VoronDesign/voron-downdraft/STLs/Dual_4010/README.md

# Downdraft Toolhead

These parts are specific to the dual 4010 part cooling toolhead.

The Left and Right Fan mounts house the part cooling fans.

The various Front mounts place the hotend cooling fan at different heights. The height is determined by the location of the heatsink on the hotend. See the [HARDWARE_COMPATIBILITY_LIST](../../HARDWARE_COMPATIBILITY_LIST.md) file for a list of common hotends and which Front mount to use.
