VoronDesign/voron-downdraft/STLs/Extras/Front_Mount_Cutter_Models/README.md

# Downdraft Toolhead

These Front mounts have decorative patterns cut into them. You can either print the 3mf files in 2 colours, or you can hide the cutter parts and print the main Front part to have single colour indented print.
