VoronDesign/voron-downdraft/STLs/Extras/LED_Jigs/README.md

# Downdraft Toolhead

These parts (jigs) are provided to help with soldering wires to the Logo and Nozzle LED's keeping the wires to an appropriate length.
