VoronDesign/voron-downdraft/STLs/Common_Parts/Hotend_Mounts/README.md

# Downdraft Toolhead

Various hotend mounts are provided for mounting to the toolhead. The length of the toolhead and the location of the heatsink is used to determine which height of the toolhead Front mount to use for the hotend fan.
