VoronDesign/voron-downdraft/STLs/Common_Parts/LED_Mounts/README.md

# Downdraft Toolhead

### Logo_LED

Contains parts for an LED behind the logo on the Front part of the toolhead

### Nozzle_LED

Contains parts for logo LED's that direct their light towards the hotend nozzle
