VoronDesign/voron-downdraft/STLs/Common_Parts/Bowden_Mount_Collet.stl

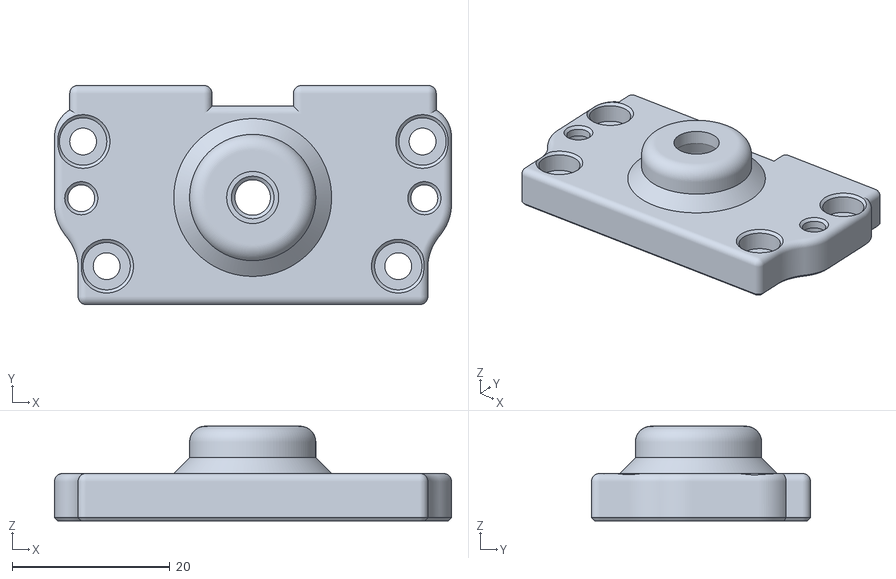
[picture p2: CAD file, 2026-10-25]
STLs/Common_Parts/Bowden_Mount_Collet.stl
50.3 x 27.8 x 12.0
