VoronDesign/voron-downdraft/STLs/Common_Parts/Hotend_Mounts/RapidoHF_DragonVolcano_Mount.stl

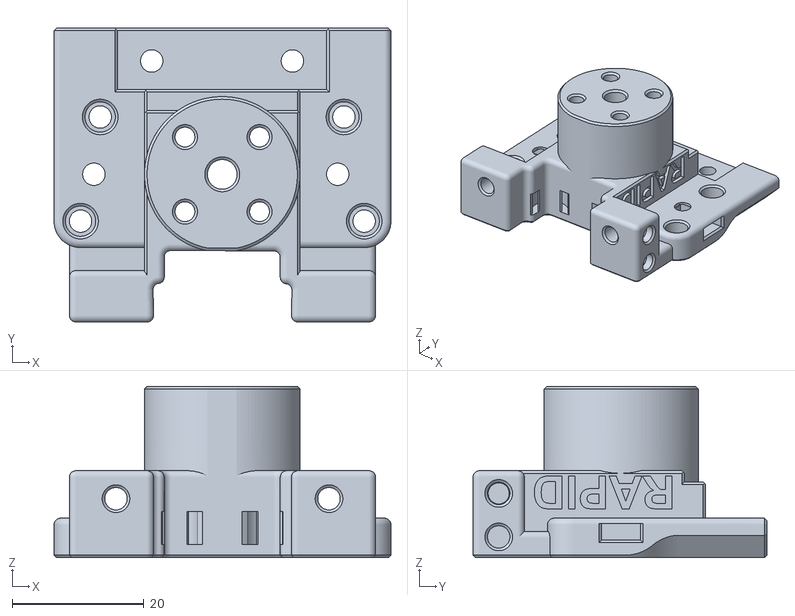
[picture p3: CAD file, 2026-10-25]
STLs/Common_Parts/Hotend_Mounts/RapidoHF_DragonVolcano_Mount.stl
51.1 x 44.6 x 26.0
