VoronDesign/voron-downdraft/STLs/Common_Parts/LED_Mounts/Logo_LED/[c]_LED_Diffuser.stl

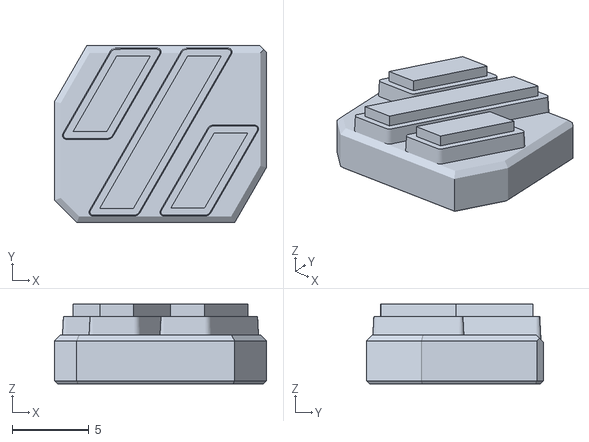
[picture p4: CAD file, 2026-10-25]
STLs/Common_Parts/LED_Mounts/Logo_LED/[c]_LED_Diffuser.stl
13.8 x 11.5 x 5.20
