VoronDesign/voron-downdraft/STLs/Common_Parts/LED_Mounts/Nozzle_LED/Nozzle_LEDx1_Mount.stl

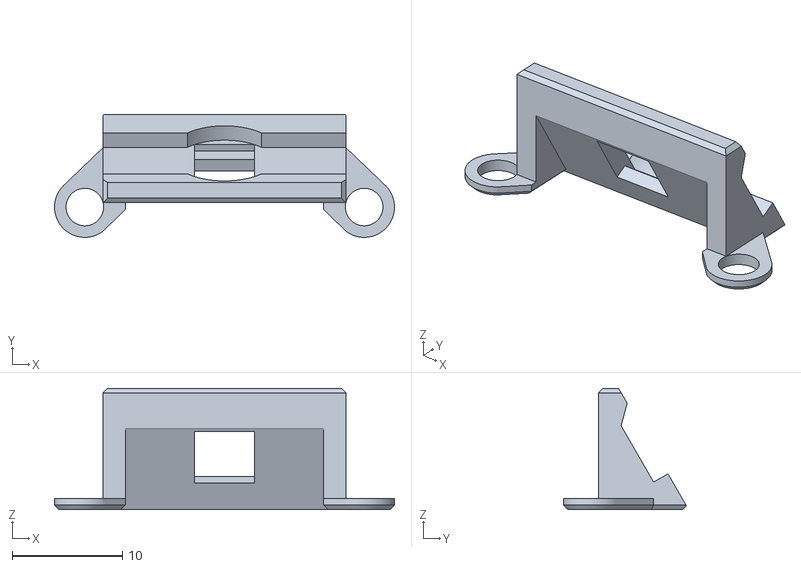
[picture p5: CAD file, 2026-10-25]
STLs/Common_Parts/LED_Mounts/Nozzle_LED/Nozzle_LEDx1_Mount.stl
30.8 x 11.1 x 11.0
