VoronDesign/voron-downdraft/STLs/Common_Parts/PCB_And_Chain_Mounts/Umbilical_PCB_Mounts/PUG_Generic/Umbilical_PCB36_Pug_Mount_Right.stl

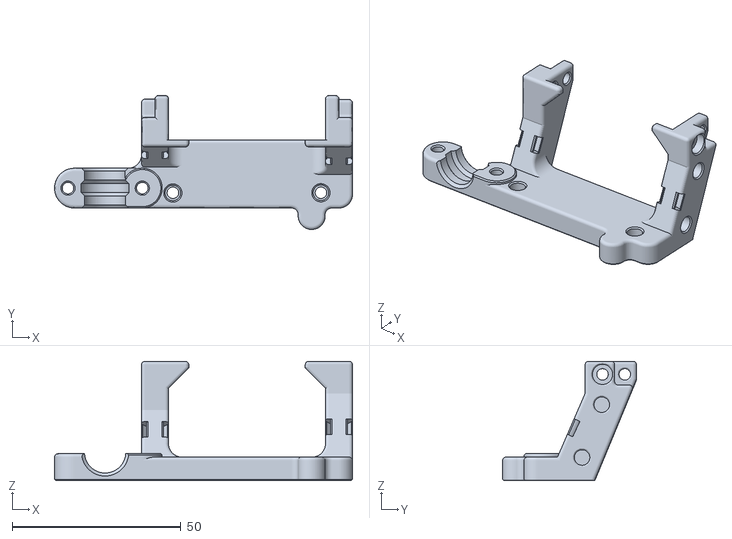
[picture p8: CAD file, 2026-11-10]
STLs/Common_Parts/PCB_And_Chain_Mounts/Umbilical_PCB_Mounts/PUG_Generic/Umbilical_PCB36_Pug_Mount_Right.stl
88.3 x 39.7 x 35.4
