VoronDesign/voron-downdraft/STLs/Common_Parts/PCB_And_Chain_Mounts/Umbilical_PCB_Mounts/WWG2_Umbilical_PCB36_Mount.stl

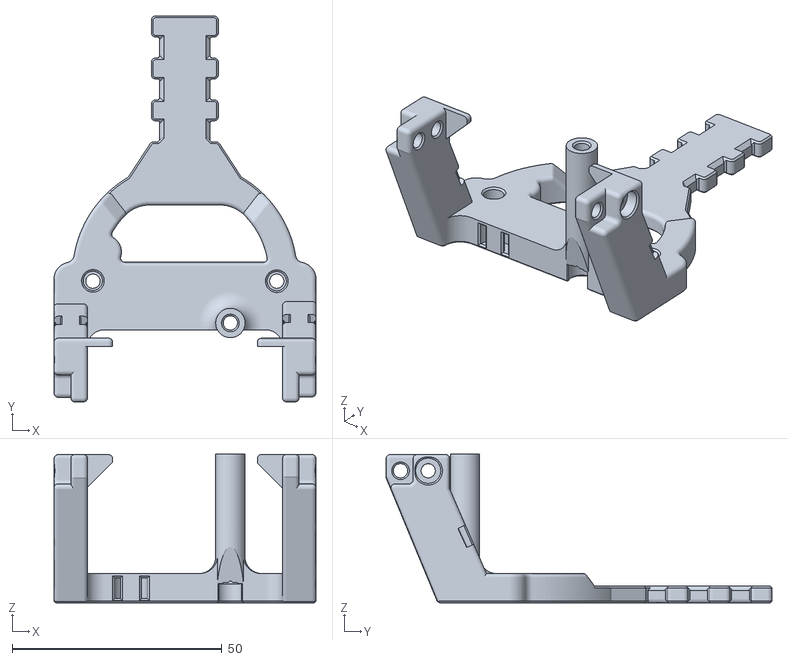
[picture p10: CAD file, 2026-11-10]
STLs/Common_Parts/PCB_And_Chain_Mounts/Umbilical_PCB_Mounts/WWG2_Umbilical_PCB36_Mount.stl
62.5 x 92.0 x 35.5
