VoronDesign/voron-downdraft/STLs/Dual_4010/[a]_4010_Front_Mount_Middle.stl

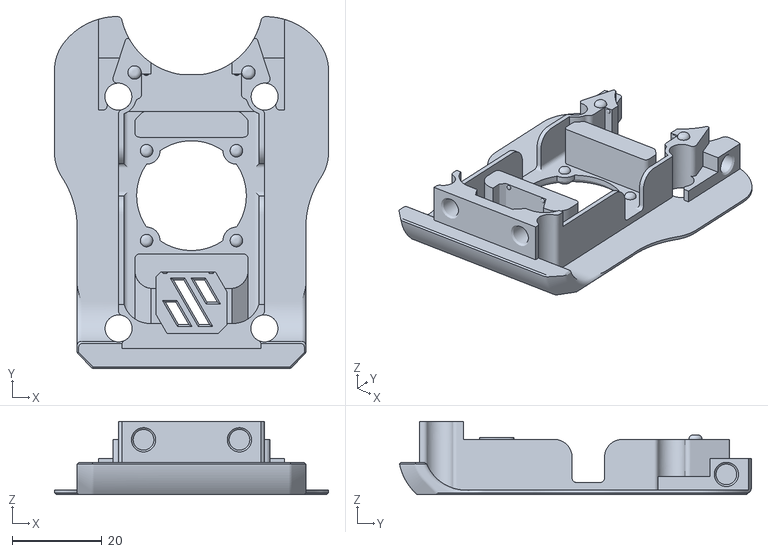
[picture p11: CAD file, 2026-10-25]
STLs/Dual_4010/[a]_4010_Front_Mount_Middle.stl
61.0 x 78.4 x 16.3
