VoronDesign/voron-downdraft/STLs/Dual_5015/5015_Fan_Mount_Left.stl

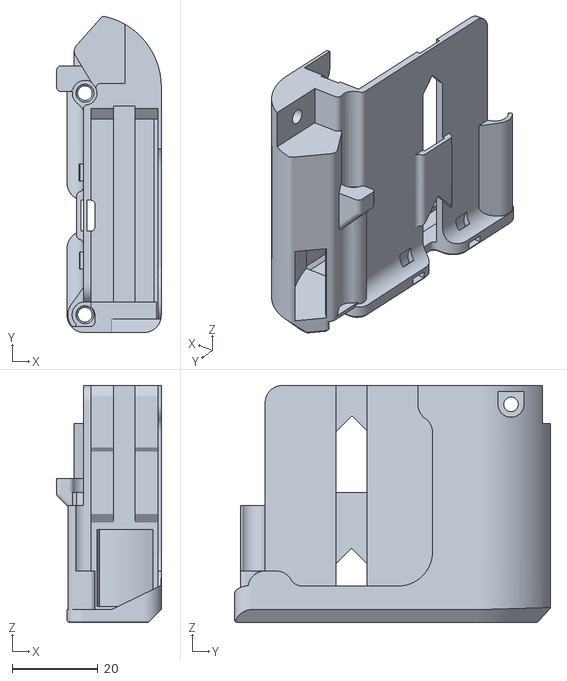
[picture p12: CAD file, 2026-10-25]
STLs/Dual_5015/5015_Fan_Mount_Left.stl
24.4 x 73.6 x 55.2
