VoronDesign/voron-downdraft/STLs/Extras/Crossbow_Cutter_Mount.stl

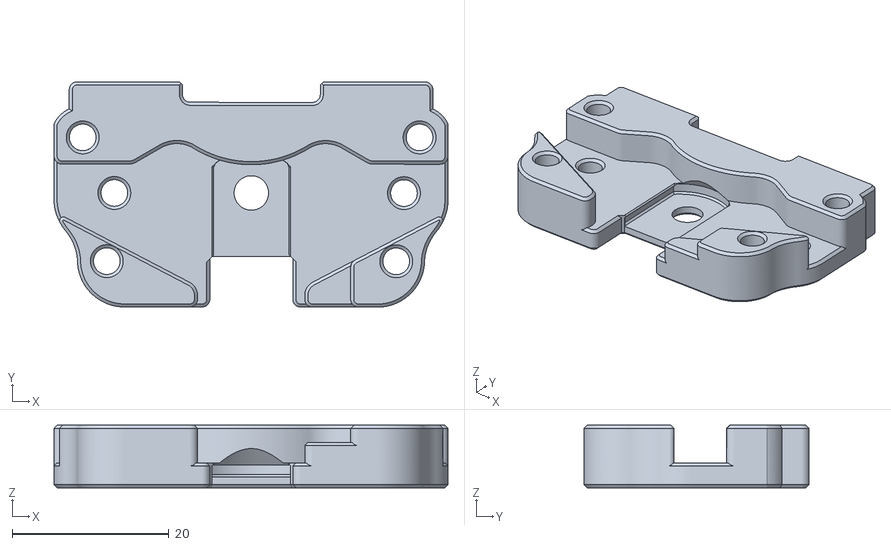
[picture p13: CAD file, 2026-10-25]
STLs/Extras/Crossbow_Cutter_Mount.stl
50.3 x 28.8 x 8.00
