VoronDesign/voron-downdraft/STLs/Extras/LED_Jigs/LEDx2_Logo_Jig.stl

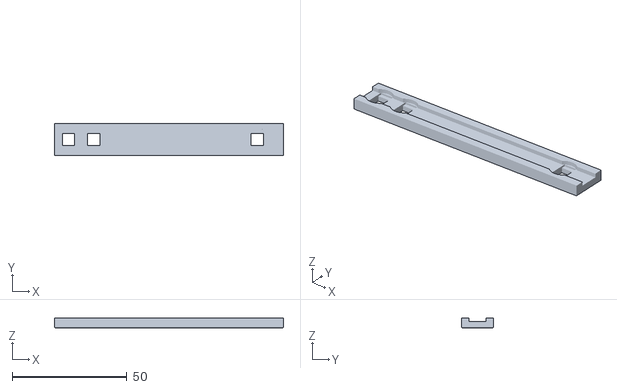
[picture p15: CAD file, 2026-10-25]
STLs/Extras/LED_Jigs/LEDx2_Logo_Jig.stl
100.0 x 14.0 x 4.50
