VoronDesign/voron-downdraft/STLs/Extras/Roto_Vitamins/Roto_Vitamin_Front_Plate_4010.stl

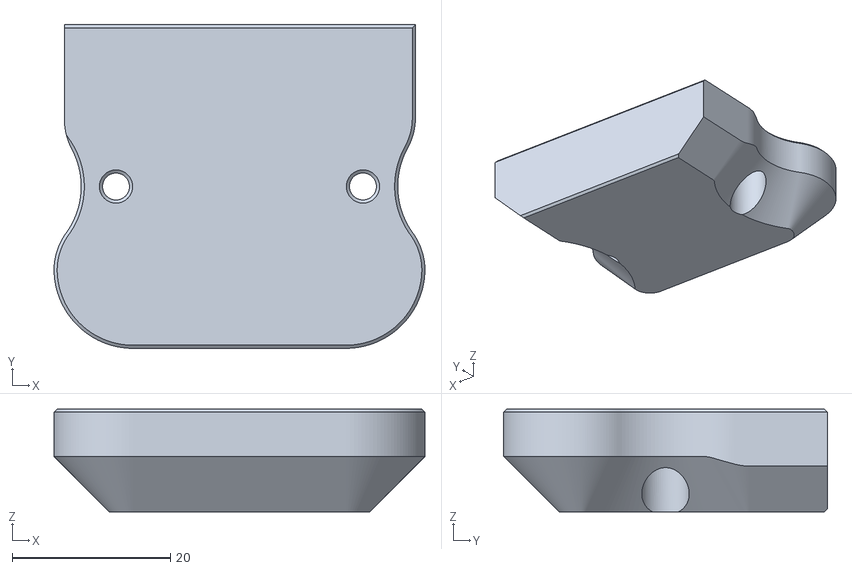
[picture p16: CAD file, 2026-10-25]
STLs/Extras/Roto_Vitamins/Roto_Vitamin_Front_Plate_4010.stl
46.9 x 40.9 x 13.0
