VoronDesign/voron-downdraft/STLs/Common_Parts/Alternative_Extruder_Spacer.stl

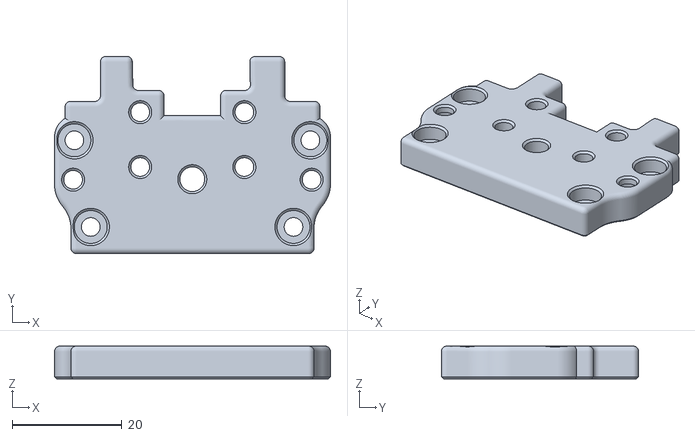
[picture p18: CAD file, 2026-10-25]
STLs/Common_Parts/Alternative_Extruder_Spacer.stl
50.3 x 36.0 x 6.00
