VoronDesign/voron-downdraft/STLs/Common_Parts/Hotend_Mounts/Chube_Compact_Mount.stl

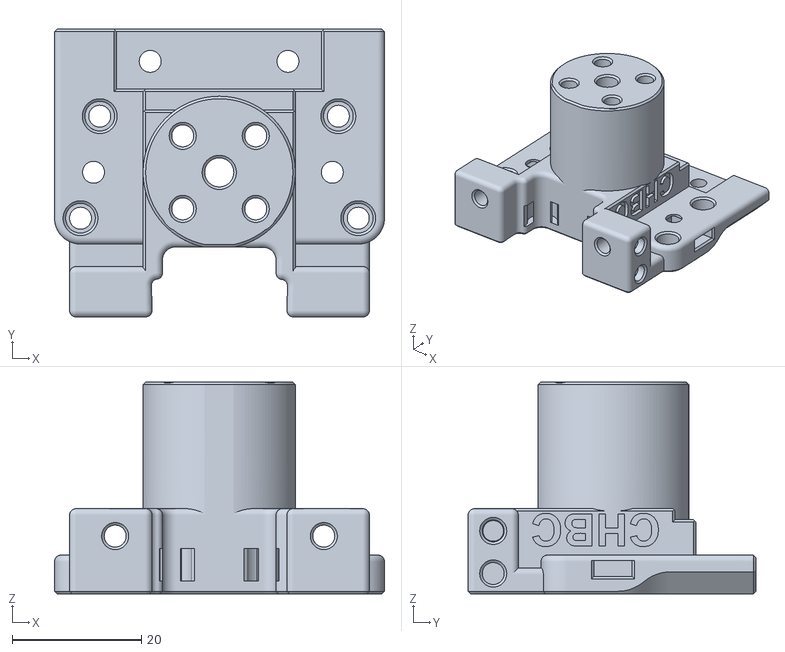
[picture p19: CAD file, 2026-10-25]
STLs/Common_Parts/Hotend_Mounts/Chube_Compact_Mount.stl
51.1 x 44.6 x 32.8
