VoronDesign/voron-downdraft/STLs/Common_Parts/LED_Mounts/Logo_LED/[o]_BARF_LED_Carrier.stl

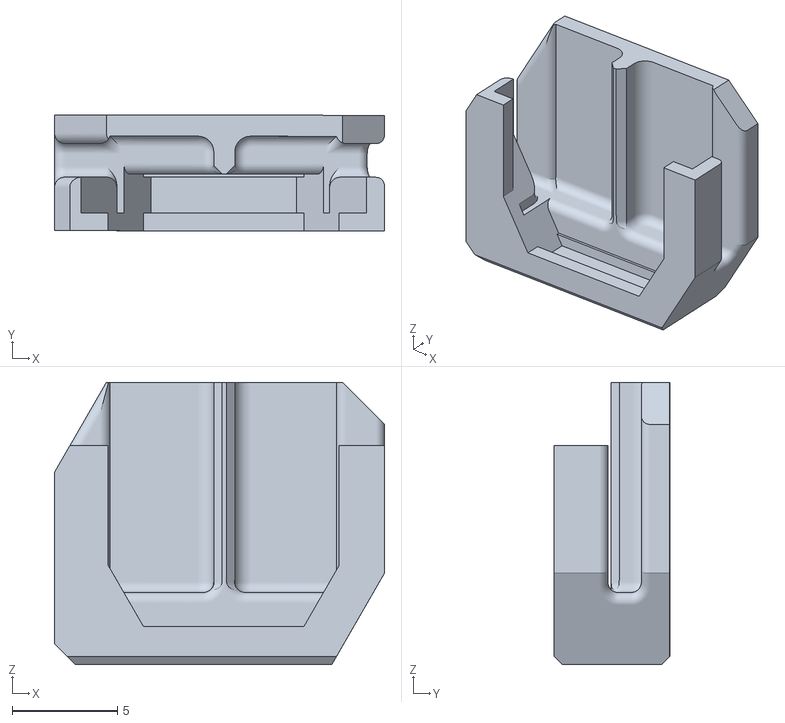
[picture p20: CAD file, 2026-10-25]
STLs/Common_Parts/LED_Mounts/Logo_LED/[o]_BARF_LED_Carrier.stl
15.7 x 5.51 x 13.4
