VoronDesign/voron-downdraft/STLs/Common_Parts/PCB_And_Chain_Mounts/PCB_4mm_Spacer_x2.stl

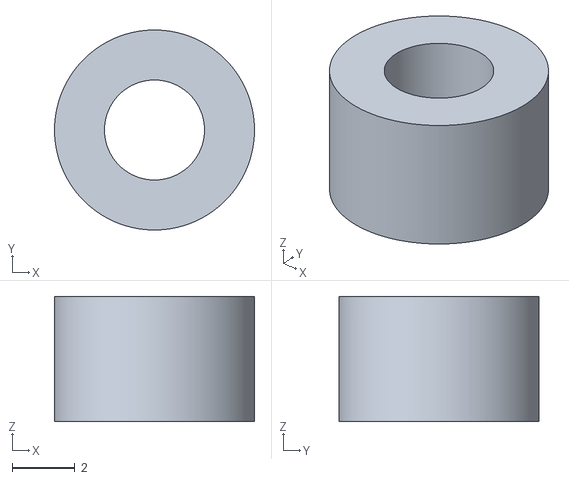
[picture p23: CAD file, 2026-10-25]
STLs/Common_Parts/PCB_And_Chain_Mounts/PCB_4mm_Spacer_x2.stl
6.40 x 6.40 x 4.00
