VoronDesign/voron-downdraft/STLs/Dual_4010/4010_Fan_Mount_Right.stl

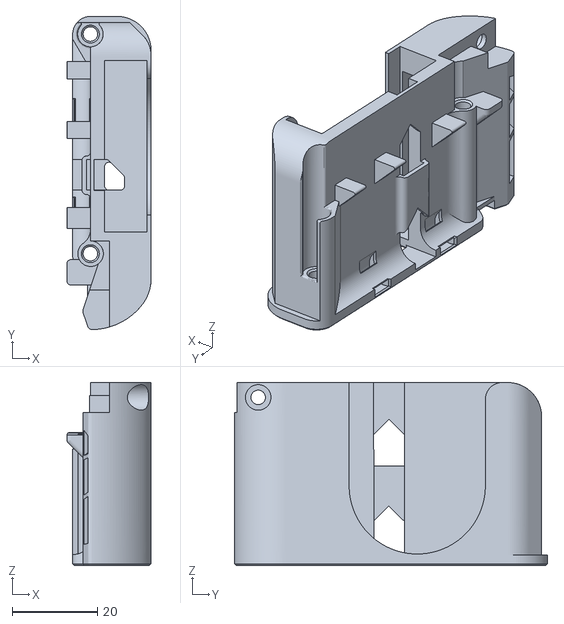
[picture p26: CAD file, 2026-10-25]
STLs/Dual_4010/4010_Fan_Mount_Right.stl
19.8 x 73.6 x 43.0
