VoronDesign/voron-downdraft/STLs/Dual_5015/5015_Fan_Mount_Right.stl

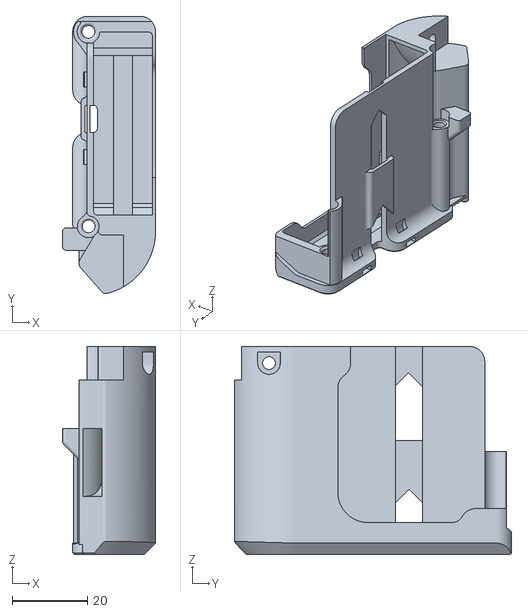
[picture p27: CAD file, 2026-10-25]
STLs/Dual_5015/5015_Fan_Mount_Right.stl
24.6 x 73.6 x 55.2
