VoronDesign/voron-downdraft/STLs/Extras/Generic_ADXL_Mount.stl

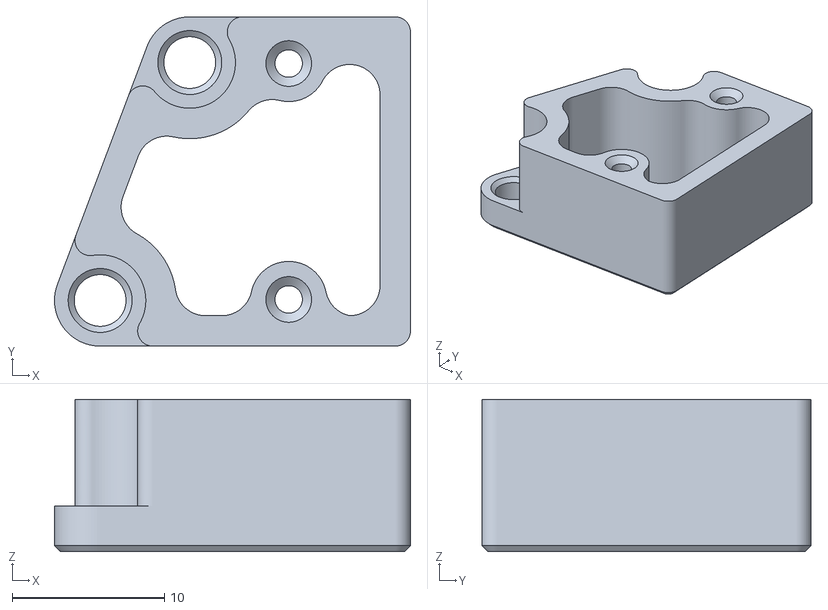
[picture p28: CAD file, 2026-10-25]
STLs/Extras/Generic_ADXL_Mount.stl
23.4 x 21.6 x 10.0
