VoronDesign/voron-downdraft/STLs/Extras/Roto_Vitamins/Roto_Vitamins_Cover.stl

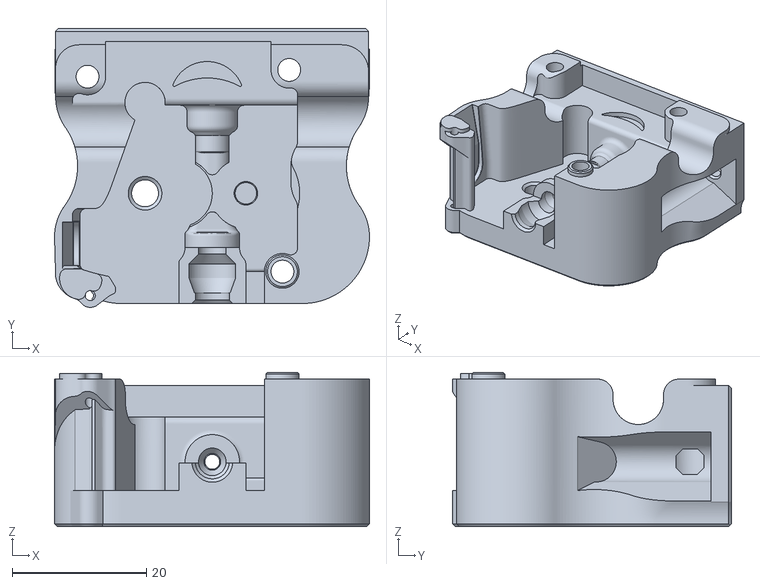
[picture p29: CAD file, 2026-10-25]
STLs/Extras/Roto_Vitamins/Roto_Vitamins_Cover.stl
46.9 x 41.5 x 22.9
