VoronDesign/voron-downdraft/STLs/Extras/WWG2/WWG2_Front_Body_ECAS_HS.stl

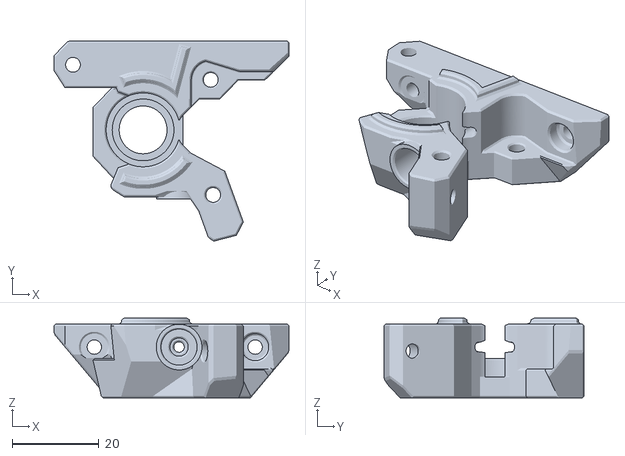
[picture p30: CAD file, 2026-10-25]
STLs/Extras/WWG2/WWG2_Front_Body_ECAS_HS.stl
54.1 x 46.1 x 18.4
