VoronDesign/voron-downdraft/STLs/Common_Parts/Hotend_Mounts/Dragon_Mount.stl

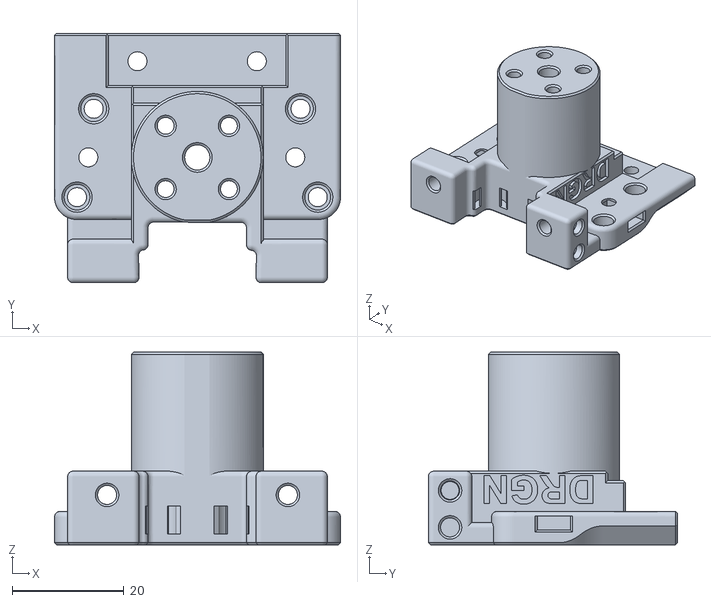
[picture p31: CAD file, 2026-10-25]
STLs/Common_Parts/Hotend_Mounts/Dragon_Mount.stl
51.1 x 44.6 x 34.5
