VoronDesign/voron-downdraft/STLs/Common_Parts/LED_Mounts/Logo_LED/[o]_LED_Diffuser_Mask.stl

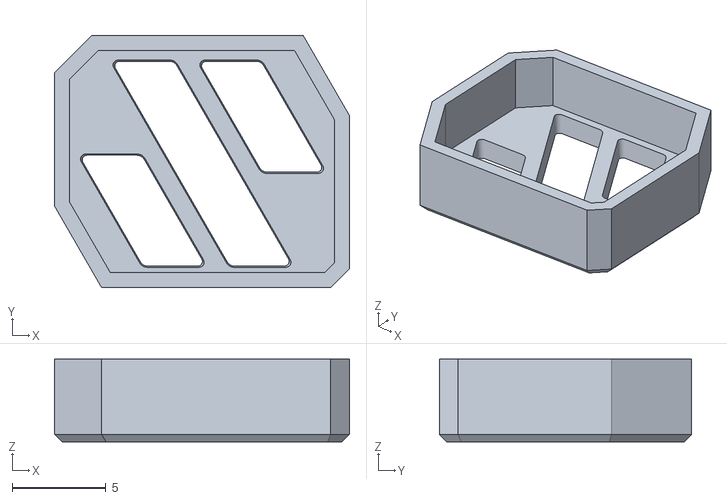
[picture p32: CAD file, 2026-10-25]
STLs/Common_Parts/LED_Mounts/Logo_LED/[o]_LED_Diffuser_Mask.stl
15.7 x 13.4 x 4.40
