VoronDesign/voron-downdraft/STLs/Common_Parts/LED_Mounts/Nozzle_LED/Nozzle_LED_Strip_Backer_4010.stl

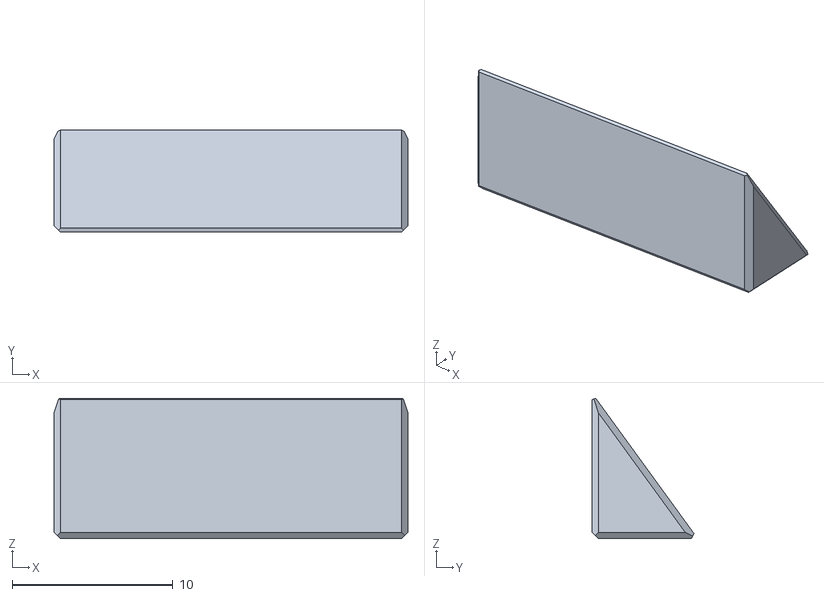
[picture p33: CAD file, 2026-10-25]
STLs/Common_Parts/LED_Mounts/Nozzle_LED/Nozzle_LED_Strip_Backer_4010.stl
22.0 x 6.34 x 8.73
