VoronDesign/voron-downdraft/STLs/Common_Parts/PCB_And_Chain_Mounts/Cable_Chain_PCB_Mounts/E3DRV_2hole_Chain_SB_NH_36_PCB_Mount.stl

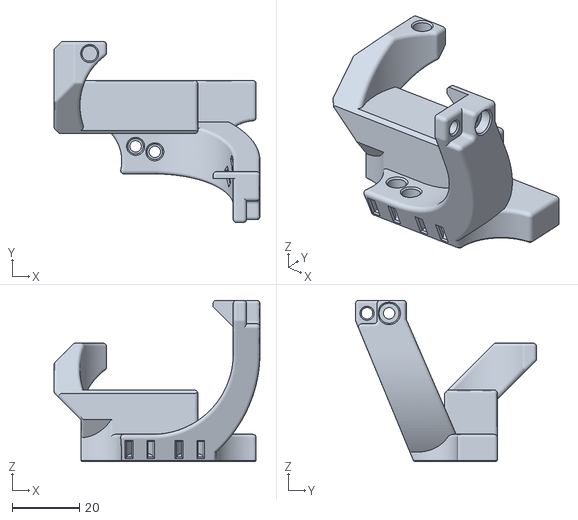
[picture p34: CAD file, 2026-11-10]
STLs/Common_Parts/PCB_And_Chain_Mounts/Cable_Chain_PCB_Mounts/E3DRV_2hole_Chain_SB_NH_36_PCB_Mount.stl
61.5 x 54.0 x 48.2
