VoronDesign/voron-downdraft/STLs/Common_Parts/PCB_And_Chain_Mounts/Umbilical_PCB_Mounts/PUG_Generic/PUG_Generic_Clamp.stl

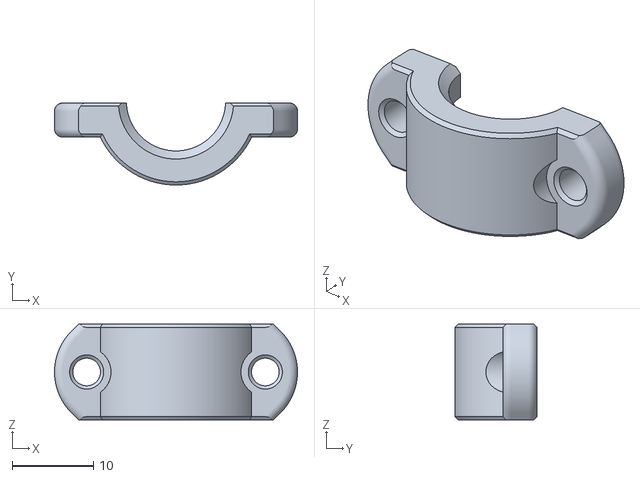
[picture p35: CAD file, 2026-10-25]
STLs/Common_Parts/PCB_And_Chain_Mounts/Umbilical_PCB_Mounts/PUG_Generic/PUG_Generic_Clamp.stl
29.9 x 10.1 x 11.8
