VoronDesign/voron-downdraft/STLs/Dual_5015/[a]_5015_Front_Mount_Middle.stl

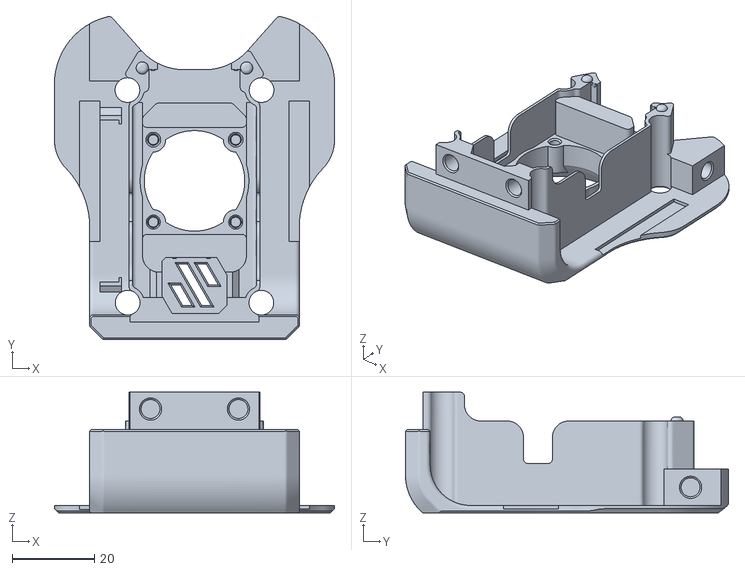
[picture p37: CAD file, 2026-10-25]
STLs/Dual_5015/[a]_5015_Front_Mount_Middle.stl
68.0 x 78.4 x 29.3
