VoronDesign/voron-downdraft/STLs/Extras/E3D_PZ_PCB_Mount.stl

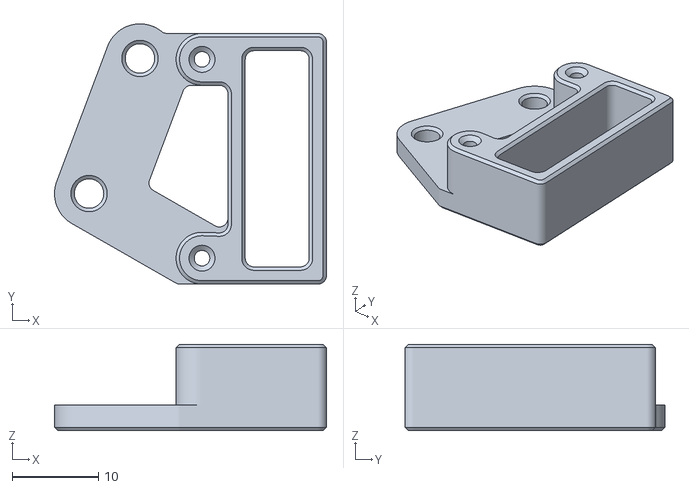
[picture p38: CAD file, 2026-10-25]
STLs/Extras/E3D_PZ_PCB_Mount.stl
31.5 x 30.1 x 10.0
