VoronDesign/voron-downdraft/STLs/Extras/Front_Mount_Cutter_Models/[a]_4010_Front_Mount_High_VORON.3mf

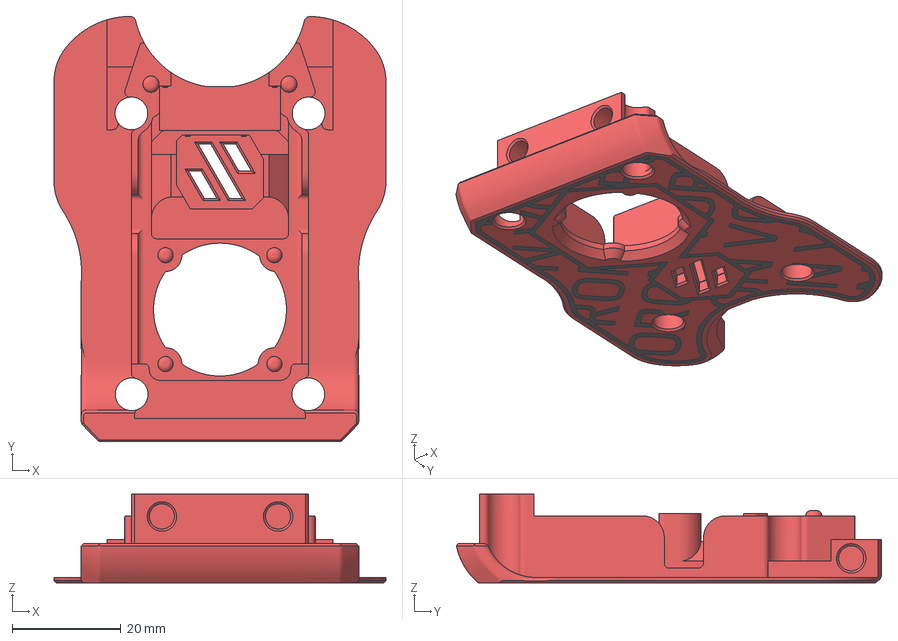
[picture p39: CAD file, 2026-10-25]
STLs/Extras/Front_Mount_Cutter_Models/[a]_4010_Front_Mount_High_VORON.3mf
61.0 x 78.1 x 16.3 mm
Main
