VoronDesign/voron-downdraft/STLs/Common_Parts/Hotend_Mounts/Blank_Mount.stl

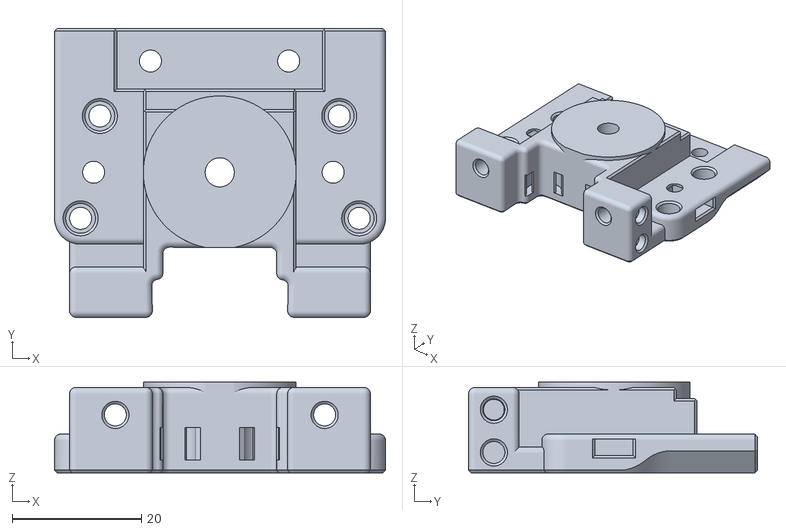
[picture p40: CAD file, 2026-10-25]
STLs/Common_Parts/Hotend_Mounts/Blank_Mount.stl
51.1 x 44.6 x 14.0
