VoronDesign/voron-downdraft/STLs/Common_Parts/LED_Mounts/Logo_LED/[o]_Neopixel_Carrier.stl

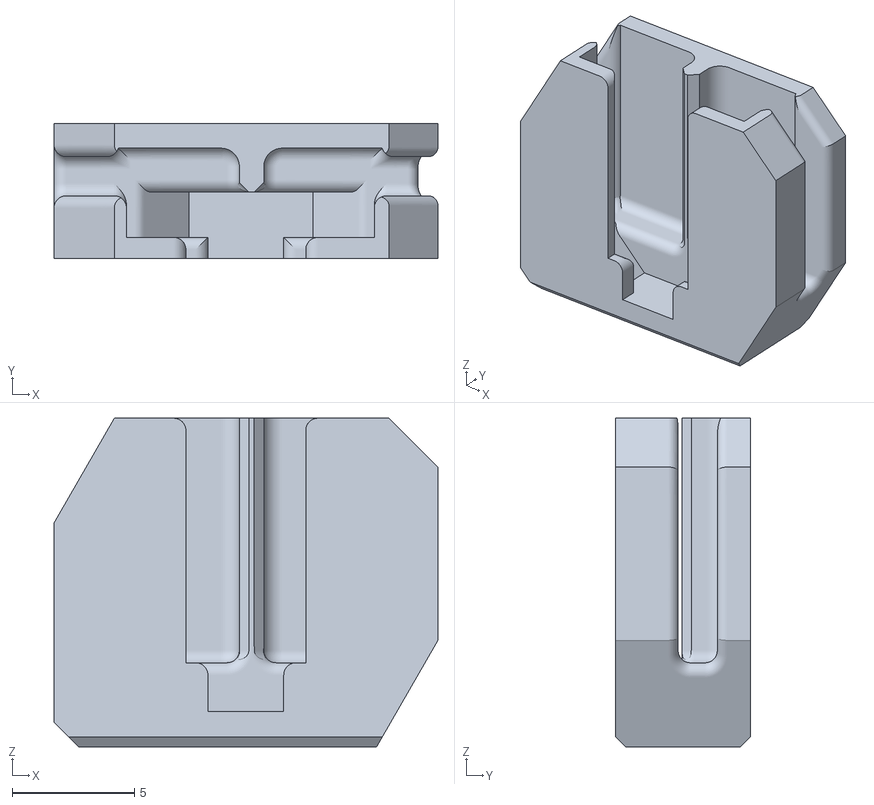
[picture p41: CAD file, 2026-10-25]
STLs/Common_Parts/LED_Mounts/Logo_LED/[o]_Neopixel_Carrier.stl
15.7 x 5.50 x 13.4
