VoronDesign/voron-downdraft/STLs/Common_Parts/LED_Mounts/Nozzle_LED/Nozzle_LED_Strip_Mount.stl

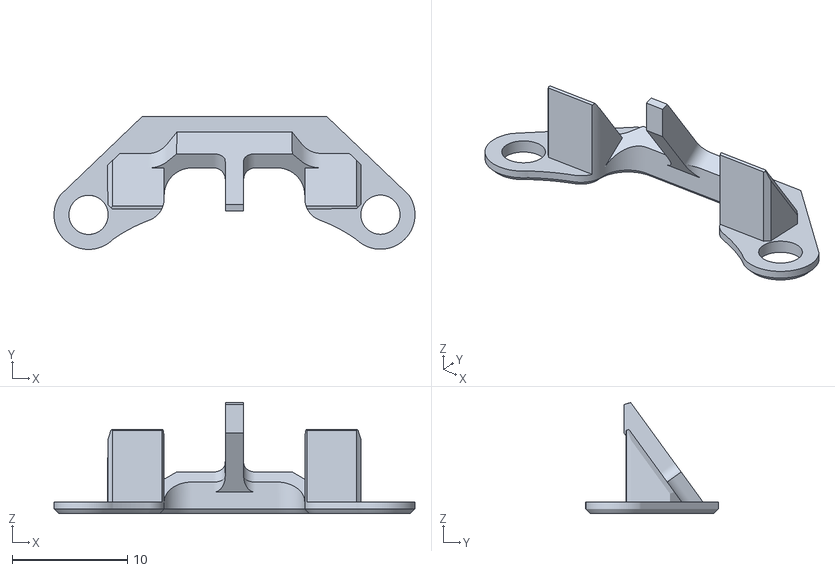
[picture p42: CAD file, 2026-10-25]
STLs/Common_Parts/LED_Mounts/Nozzle_LED/Nozzle_LED_Strip_Mount.stl
31.3 x 11.5 x 9.64
