VoronDesign/voron-downdraft/STLs/Dual_5015/5015_2510_Fan_Spacer.stl

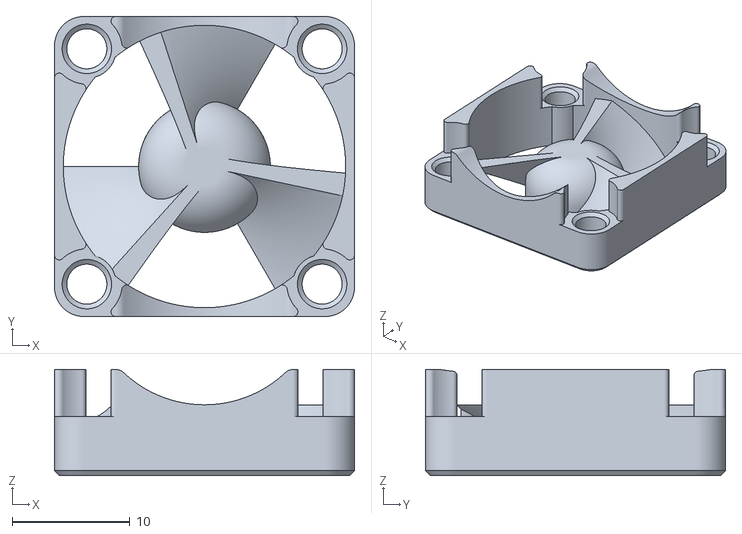
[picture p44: CAD file, 2026-10-25]
STLs/Dual_5015/5015_2510_Fan_Spacer.stl
25.5 x 25.5 x 9.01
