VoronDesign/voron-downdraft/STLs/Extras/Front_Mount_Cutter_Models/[a]_5015_Front_Mount_Middle_Hex.3mf

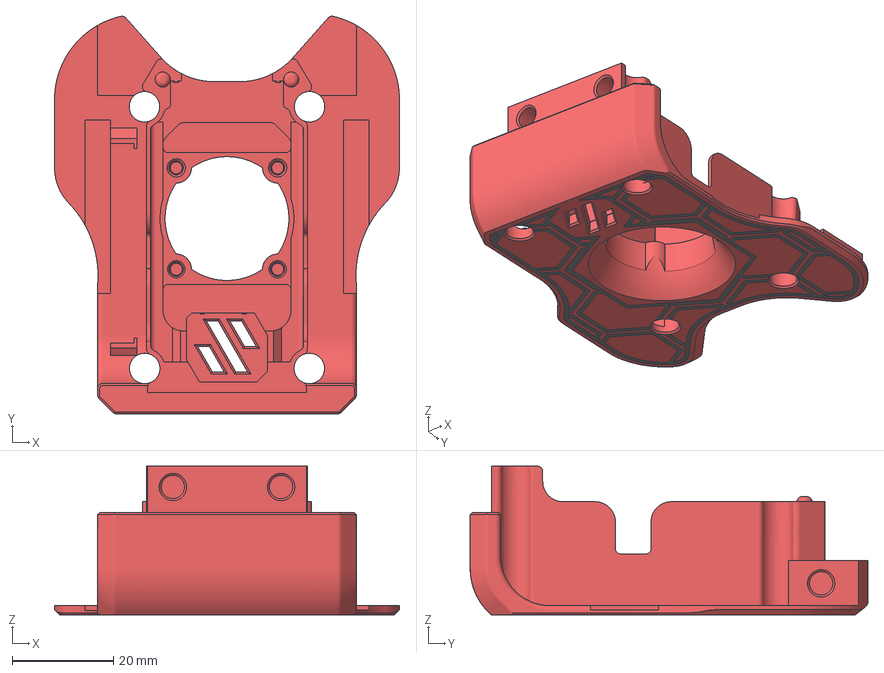
[picture p45: CAD file, 2026-10-25]
STLs/Extras/Front_Mount_Cutter_Models/[a]_5015_Front_Mount_Middle_Hex.3mf
68.0 x 78.4 x 29.3 mm
Main
