VoronDesign/voron-downdraft/STLs/Common_Parts/Hotend_Mounts/Dragon_Ace_Mount.stl

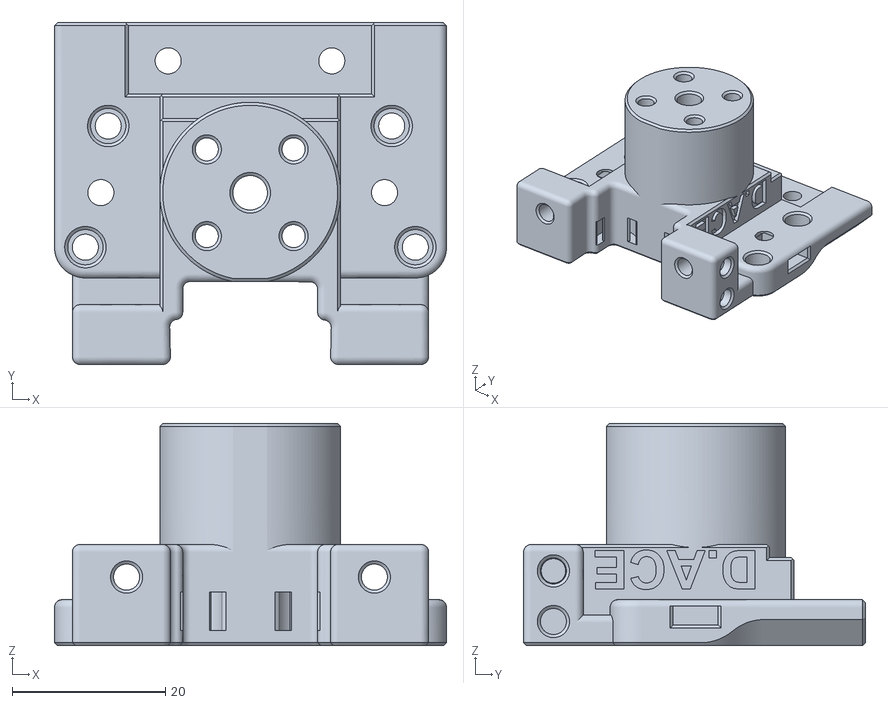
[picture p46: CAD file, 2026-10-25]
STLs/Common_Parts/Hotend_Mounts/Dragon_Ace_Mount.stl
51.1 x 44.6 x 29.0
