VoronDesign/voron-downdraft/STLs/Common_Parts/LED_Mounts/Nozzle_LED/Nozzle_LED_Strip_Backer_5015.stl

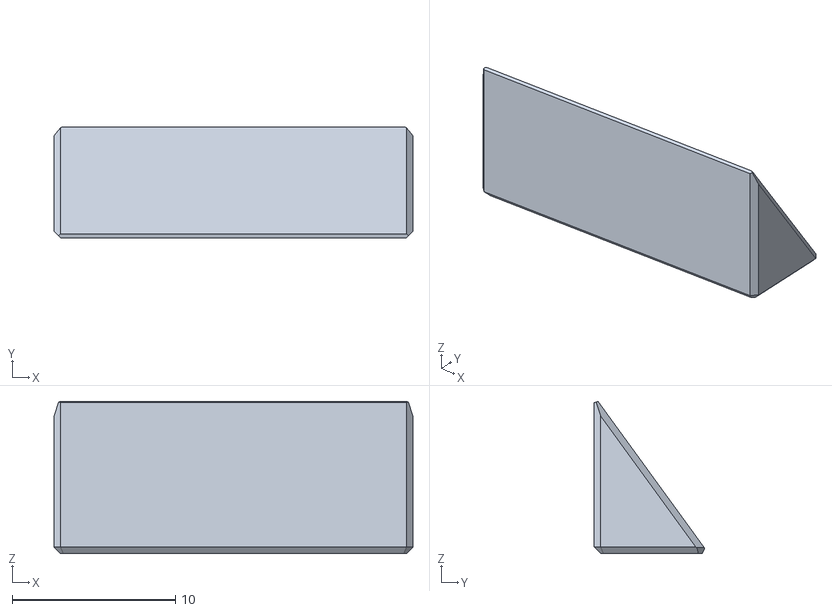
[picture p47: CAD file, 2026-10-25]
STLs/Common_Parts/LED_Mounts/Nozzle_LED/Nozzle_LED_Strip_Backer_5015.stl
22.0 x 6.78 x 9.33
