VoronDesign/voron-downdraft/STLs/Common_Parts/PCB_And_Chain_Mounts/Umbilical_PCB_Mounts/PUG_Integrated/Generic_Left_Umbilical_PCB36_Pug_Mount.stl

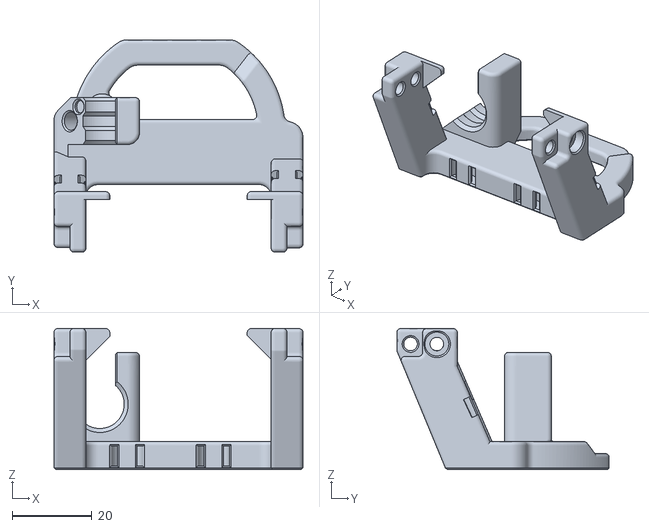
[picture p49: CAD file, 2026-11-10]
STLs/Common_Parts/PCB_And_Chain_Mounts/Umbilical_PCB_Mounts/PUG_Integrated/Generic_Left_Umbilical_PCB36_Pug_Mount.stl
62.5 x 53.3 x 35.4
