VoronDesign/voron-downdraft/STLs/Dual_5015/5015_Fan_Spring_x2.stl

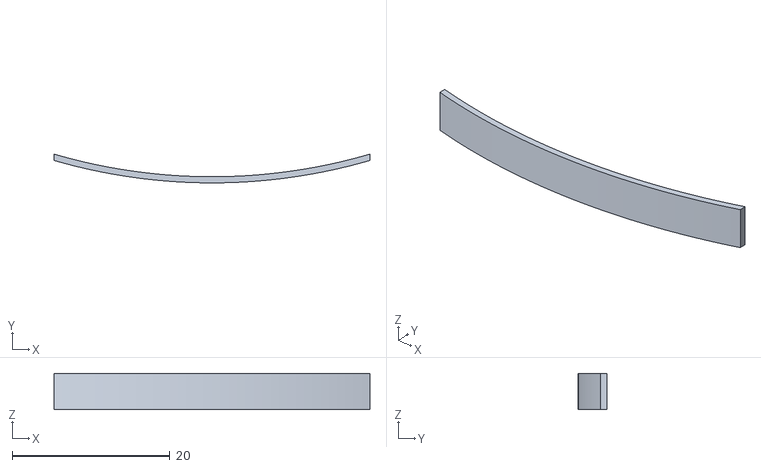
[picture p50: CAD file, 2026-10-25]
STLs/Dual_5015/5015_Fan_Spring_x2.stl
40.0 x 3.65 x 4.60
