VoronDesign/voron-downdraft/STLs/Common_Parts/Hotend_Mounts/ReVolcano_Mount.stl

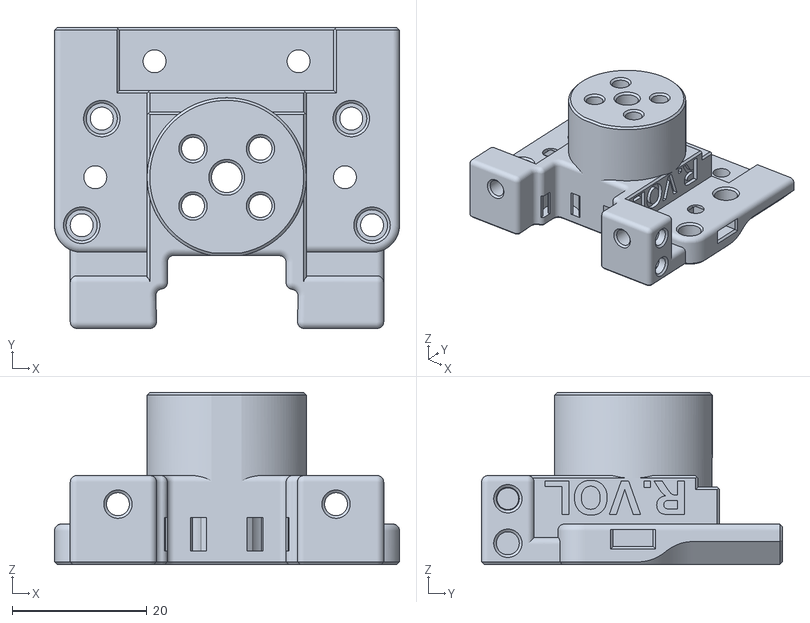
[picture p51: CAD file, 2026-10-25]
STLs/Common_Parts/Hotend_Mounts/ReVolcano_Mount.stl
51.1 x 44.6 x 25.5
