VoronDesign/voron-downdraft/STLs/Common_Parts/Hotend_Mounts/Rapido_X_Mount.stl

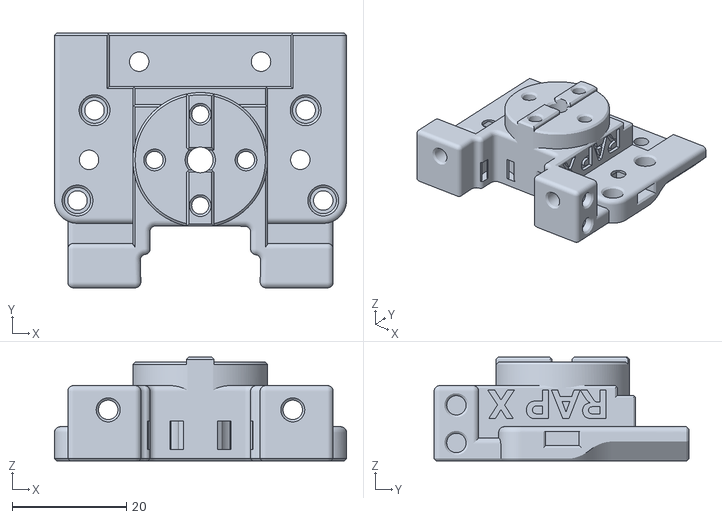
[picture p55: CAD file, 2026-10-25]
STLs/Common_Parts/Hotend_Mounts/Rapido_X_Mount.stl
51.1 x 44.6 x 18.2
