VoronDesign/voron-downdraft/STLs/Common_Parts/PCB_And_Chain_Mounts/Cable_Chain_PCB_Mounts/OB2_3hole_Chain_SB_NH_36_PCB_Mount.stl

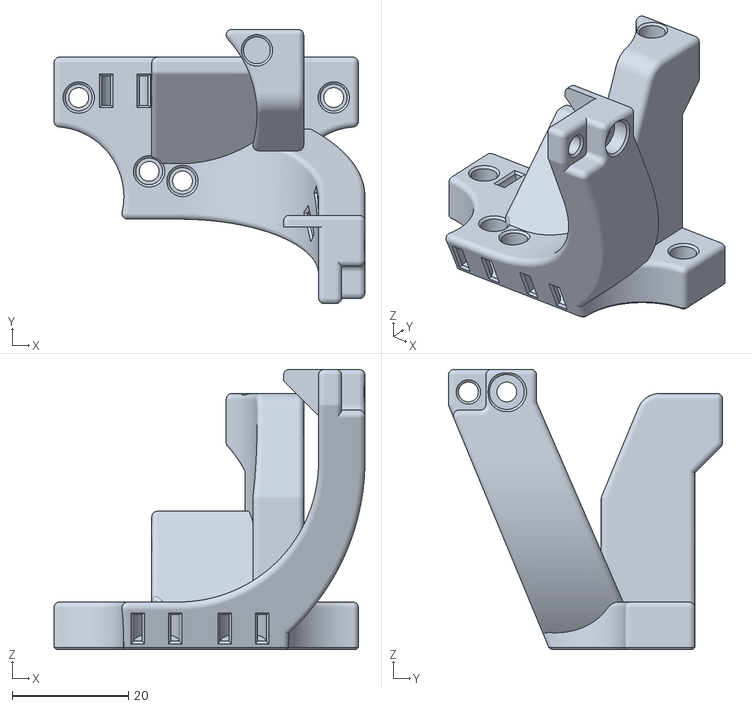
[picture p56: CAD file, 2026-11-10]
STLs/Common_Parts/PCB_And_Chain_Mounts/Cable_Chain_PCB_Mounts/OB2_3hole_Chain_SB_NH_36_PCB_Mount.stl
53.5 x 47.2 x 48.2
