VoronDesign/voron-downdraft/STLs/Common_Parts/PCB_And_Chain_Mounts/Umbilical_PCB_Mounts/xSB_PCB_Mount.stl

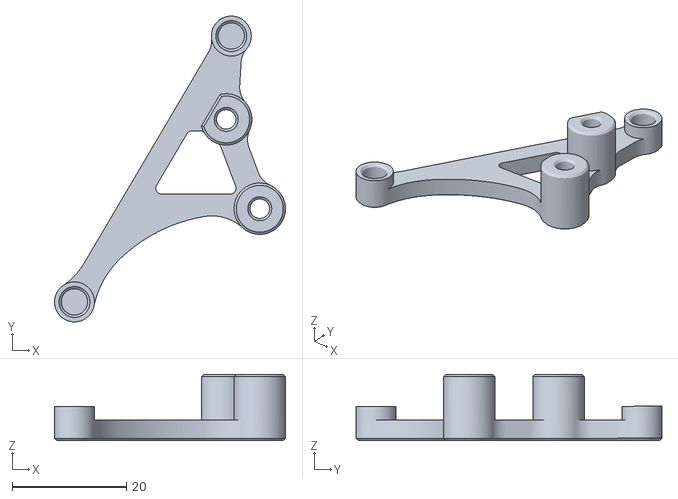
[picture p57: CAD file, 2026-10-25]
STLs/Common_Parts/PCB_And_Chain_Mounts/Umbilical_PCB_Mounts/xSB_PCB_Mount.stl
40.4 x 53.5 x 11.6
