VoronDesign/voron-downdraft/STLs/Common_Parts/Hotend_Mounts/Goliath_CHCXL_Mount.stl

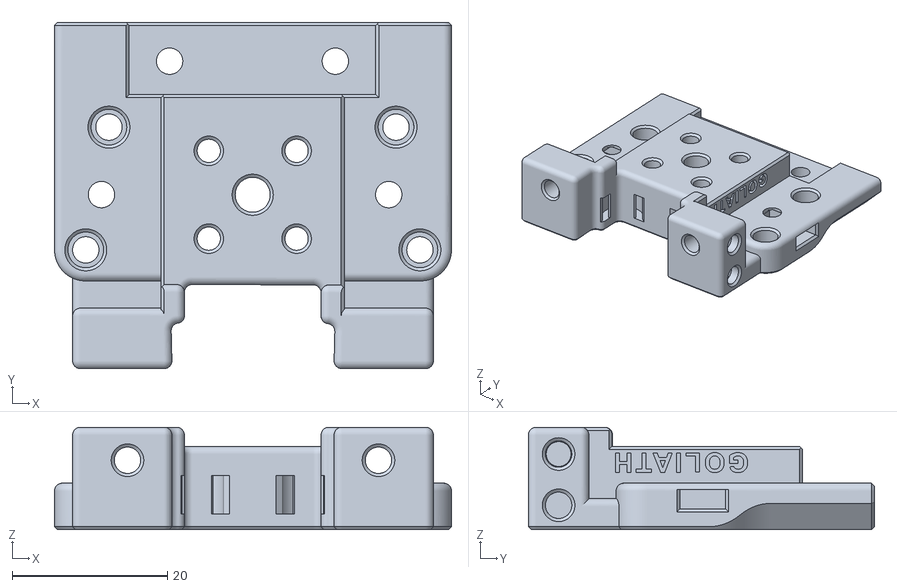
[picture p58: CAD file, 2026-10-25]
STLs/Common_Parts/Hotend_Mounts/Goliath_CHCXL_Mount.stl
51.1 x 44.6 x 13.2
