VoronDesign/voron-downdraft/STLs/Common_Parts/PCB_And_Chain_Mounts/Umbilical_PCB_Mounts/BTT_xSB_PCB_Mount.stl

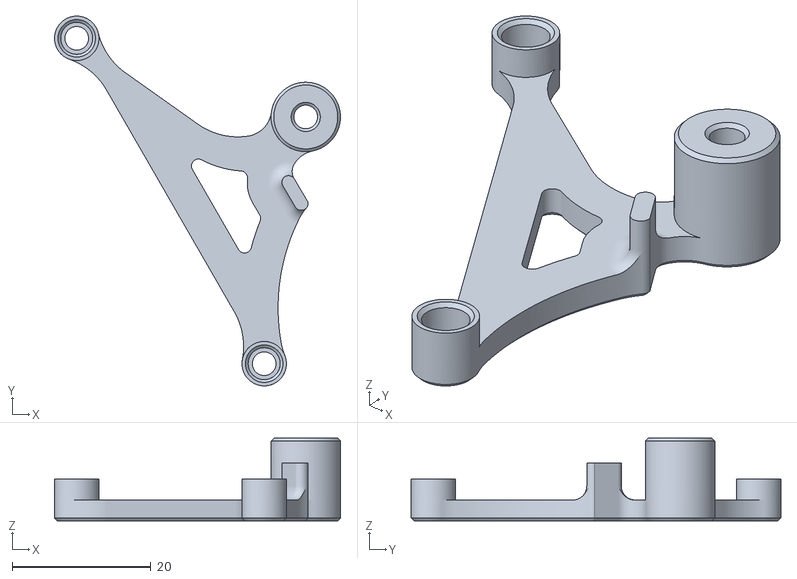
[picture p60: CAD file, 2026-10-25]
STLs/Common_Parts/PCB_And_Chain_Mounts/Umbilical_PCB_Mounts/BTT_xSB_PCB_Mount.stl
41.2 x 53.2 x 11.9
