VoronDesign/voron-downdraft/STLs/Common_Parts/PCB_And_Chain_Mounts/Umbilical_PCB_Mounts/PUG_Integrated/PUG_Integrated_Clamp.stl

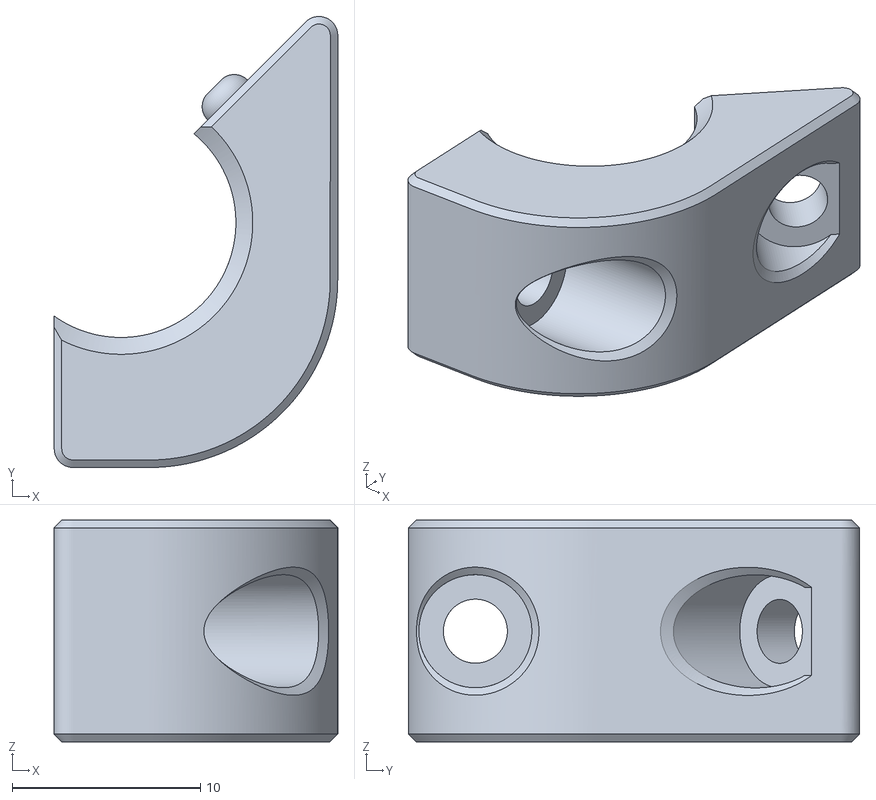
[picture p61: CAD file, 2026-10-25]
STLs/Common_Parts/PCB_And_Chain_Mounts/Umbilical_PCB_Mounts/PUG_Integrated/PUG_Integrated_Clamp.stl
15.1 x 23.9 x 11.8
