VoronDesign/voron-downdraft/STLs/Common_Parts/Hotend_Mounts/Revo_Voron_Mount.stl

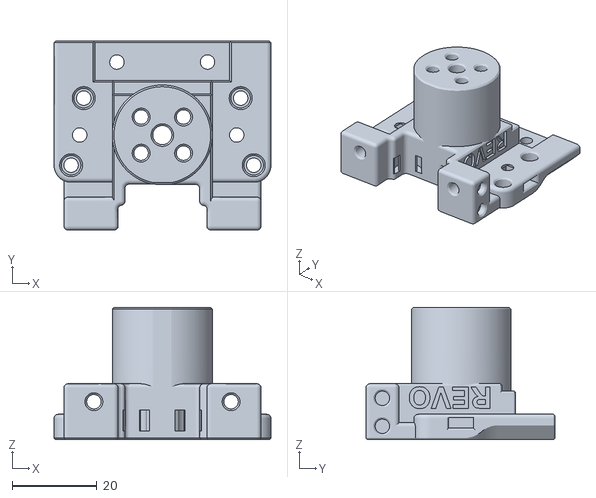
[picture p62: CAD file, 2026-10-25]
STLs/Common_Parts/Hotend_Mounts/Revo_Voron_Mount.stl
51.1 x 44.6 x 31.2
