VoronDesign/voron-downdraft/STLs/Common_Parts/PCB_And_Chain_Mounts/Cable_Chain_PCB_Mounts/3hole_Chain_SB_NH_36_PCB_Mount.stl

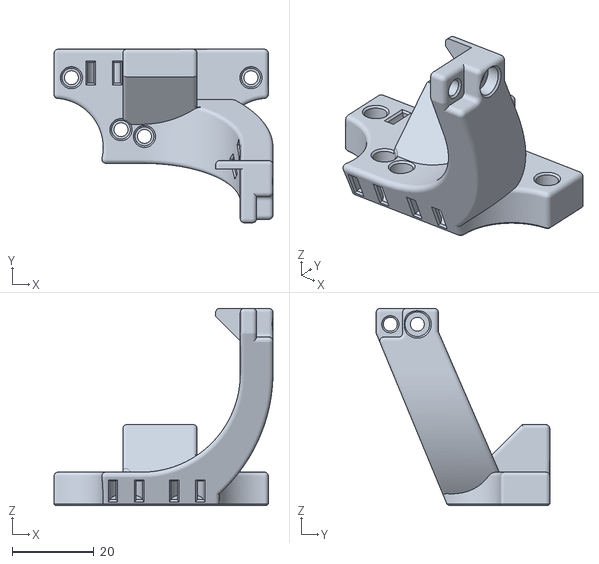
[picture p65: CAD file, 2026-11-10]
STLs/Common_Parts/PCB_And_Chain_Mounts/Cable_Chain_PCB_Mounts/3hole_Chain_SB_NH_36_PCB_Mount.stl
53.5 x 42.4 x 48.2
