VoronDesign/voron-downdraft/STLs/Common_Parts/PCB_And_Chain_Mounts/Cable_Chain_PCB_Mounts/G2SA_2hole_Chain_SB_NH_36_PCB_Mount.stl

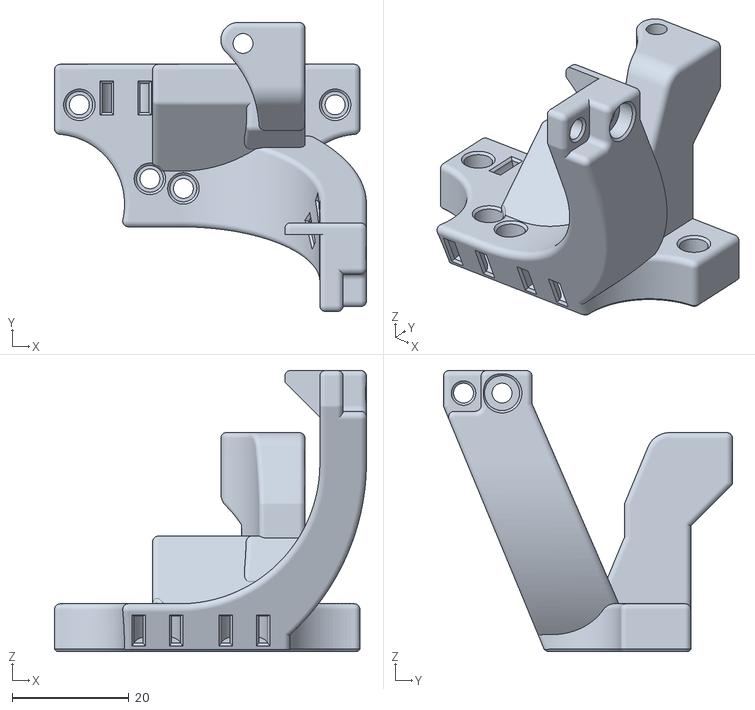
[picture p68: CAD file, 2026-11-10]
STLs/Common_Parts/PCB_And_Chain_Mounts/Cable_Chain_PCB_Mounts/G2SA_2hole_Chain_SB_NH_36_PCB_Mount.stl
53.5 x 49.6 x 48.2
