VoronDesign/voron-downdraft/STLs/Common_Parts/Hotend_Mounts/Dragon_Ace_Mount_MZE.stl

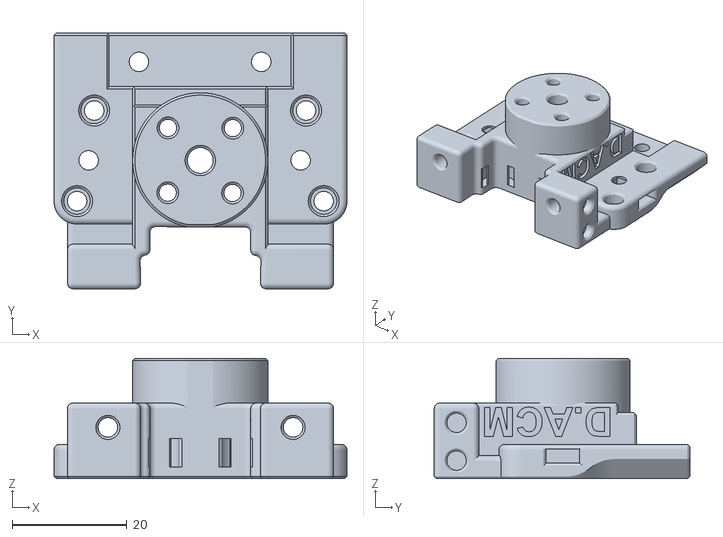
[picture p69: CAD file, 2026-10-25]
STLs/Common_Parts/Hotend_Mounts/Dragon_Ace_Mount_MZE.stl
51.1 x 44.6 x 21.0
