VoronDesign/voron-downdraft/STLs/Common_Parts/Hotend_Mounts/Dragon_Rapido_UHF_Mount.stl

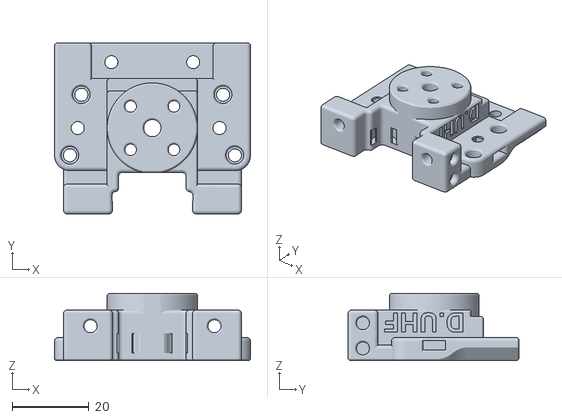
[picture p70: CAD file, 2026-10-25]
STLs/Common_Parts/Hotend_Mounts/Dragon_Rapido_UHF_Mount.stl
51.1 x 44.6 x 17.5
