VoronDesign/voron-downdraft/(list of files, cad)

Other CAD files:
STLs/Common_Parts/PCB_And_Chain_Mounts/Umbilical_PCB_Mounts/G2SA_Umbilical_PCB36_Mount.stl
STLs/Extras/Front_Mount_Cutter_Models/[a]_4010_Front_Mount_Middle_Brick.3mf
STLs/Extras/LED_Jigs/LED_Strip_Logo_Jig.stl
STLs/Common_Parts/Bowden_Mount_ECAS.stl
STLs/Common_Parts/PCB_And_Chain_Mounts/Umbilical_PCB_Mounts/PUG_Integrated/WWG2_Umbilical_PCB36_Pug_Mount.stl
STLs/Dual_4010/4010_Fan_Mount_Left.stl
STLs/Extras/LED_Jigs/LEDx1_Logo_Jig.stl
STLs/Common_Parts/PCB_And_Chain_Mounts/Umbilical_PCB_Mounts/E3DRV_Umbilical_PCB36_Mount.stl
STLs/Common_Parts/PCB_And_Chain_Mounts/Umbilical_PCB_Mounts/PUG_Integrated/WWG2_DFS_Umbilical_PCB36_Pug_Mount.stl
STLs/Dual_4010/[a]_4010_Front_Mount_High.stl
STLs/Common_Parts/PCB_And_Chain_Mounts/Umbilical_PCB_Mounts/OB2_Umbilical_PCB36_Mount.stl
STLs/Dual_4010/[a]_4010_Front_Mount_Low.stl
STLs/Extras/Front_Mount_Cutter_Models/[a]_5015_Front_Mount_High_VORON.3mf
STLs/Common_Parts/PCB_And_Chain_Mounts/Umbilical_PCB_Mounts/WWBMG_Umbilical_PCB36_Mount.stl
STLs/Dual_5015/[a]_5015_Front_Mount_Low.stl
STLs/Common_Parts/PCB_And_Chain_Mounts/Umbilical_PCB_Mounts/PUG_Integrated/ORB2_Umbilical_PCB36_Pug_Mount.stl
STLs/Dual_5015/[a]_5015_Front_Mount_High.stl
STLs/Extras/Front_Mount_Cutter_Models/[a]_5015_Front_Mount_High_Hex.3mf
STLs/Extras/Front_Mount_Cutter_Models/[a]_4010_Front_Mount_Low_VORON.3mf
STLs/Extras/Front_Mount_Cutter_Models/[a]_5015_Front_Mount_Low_Brick.3mf
STLs/Extras/Front_Mount_Cutter_Models/[a]_4010_Front_Mount_Low_Brick.3mf
STLs/Common_Parts/Hotend_Mounts/TZ_V6_v2_Mount.stl
STLs/Common_Parts/Hotend_Mounts/Tricorn_Short_Mount.stl
STLs/Extras/Front_Mount_Cutter_Models/[a]_5015_Front_Mount_Low_VORON.3mf
STLs/Extras/Front_Mount_Cutter_Models/[a]_5015_Front_Mount_Middle_VORON.3mf
STLs/Extras/Front_Mount_Cutter_Models/[a]_4010_Front_Mount_High_Hex.3mf
STLs/Extras/Front_Mount_Cutter_Models/[a]_4010_Front_Mount_Middle_VORON.3mf
STLs/Extras/Front_Mount_Cutter_Models/[a]_4010_Front_Mount_Middle_Hex.3mf
STLs/Extras/Front_Mount_Cutter_Models/[a]_5015_Front_Mount_High_Brick.3mf
STLs/Extras/Front_Mount_Cutter_Models/[a]_4010_Front_Mount_Low_Hex.3mf
STLs/Extras/XOL-CNC-Carriage-CW2_square_nut_holder.stl
