VoronDesign/voron-downdraft/CHANGELOG.md

# DownDraft Changelog

### 2026-11-07

- Initial Release of v1.0

### 2026-11-10

- Updated all PCB mounts to include their name on the print surface for identification

- Added recommendation that GDStime 4010's are the 12000 rpm variety in the HARDWARE_COMPATIBILITY_LIST

- Updated the CAD

- Added a CHANGELOG
