VoronDesign/voron-downdraft/(commit log)

2026-10-25 DownDraft v1.0
    [2hole_Chain_SB_NH_36_PCB_Mount.stl, 3hole_Chain_SB_NH_36_PCB_Mount.stl, 4010_Fan_Mount_Left.stl, 4010_Fan_Mount_Right.stl, 5015_2510_Fan_Spacer.stl, 5015_Fan_Mount_Left.stl, 5015_Fan_Mount_Right.stl, 5015_Fan_Spring_x2.stl]
2026-11-08 Add download badge for STL files in README
    Added a badge for downloading STLs to the README.
2026-11-10 Update Downdraft_Toolheads.zip
    Updated CAD for adding names to PCB Mounts
2026-11-10 Update HARDWARE_COMPATIBILITY_LIST.md
    Added GDStime 4010 12000 rpm recommendation
2026-11-10 Added PCB Mount Name
    [2hole_Chain_SB_NH_36_PCB_Mount.stl, 3hole_Chain_SB_NH_36_PCB_Mount.stl, E3DRV_2hole_Chain_SB_NH_36_PCB_Mount.stl, E3DRV_3hole_Chain_SB_NH_36_PCB_Mount.stl, E3DRV_Umbilical_PCB36_Mount.stl, G2SA_2hole_Chain_SB_NH_36_PCB_Mount.stl, G2SA_3hole_Chain_SB_NH_36_PCB_Mount.stl, G2SA_Umbilical_PCB36_Mount.stl]
2026-11-11 Added Limitations
    Added printer configuration limitations that apply to some setups
